Ochaligne/2-DOF-helicopter-control/README.md

# 2-DOF-helicopter-control
Two degree of freedom helicopter Arduino based control prototype.

This project was interrupted by the Covid crisis. The software development was put on hold. All other activities were completed.
