Ochaligne/2-DOF-helicopter-control/MATLAB Simulation/No decoupler/System no decoupler.png

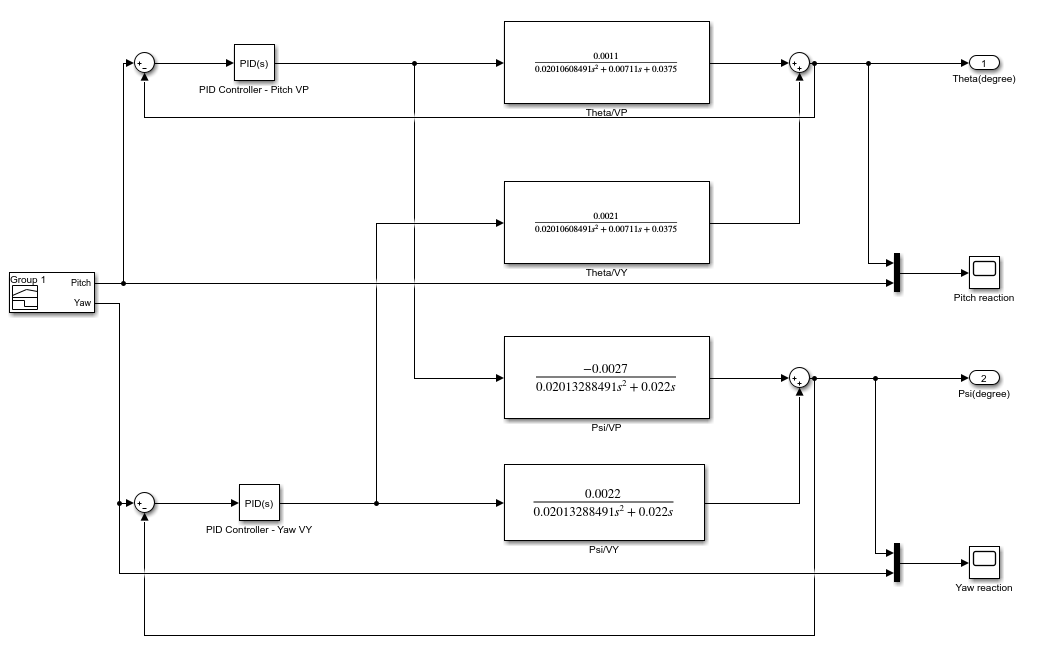
MATLAB Simulation/No decoupler/System no decoupler.png
