Ochaligne/2-DOF-helicopter-control/MATLAB Simulation/No decoupler/Yaw1.PNG

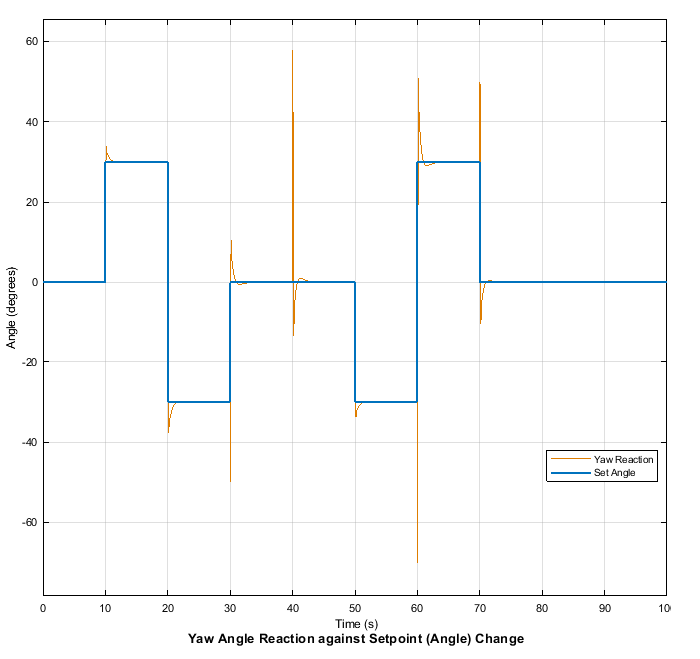
MATLAB Simulation/No decoupler/Yaw1.PNG
