Ochaligne/2-DOF-helicopter-control/MATLAB Simulation/With decoupler/Pitch2.PNG

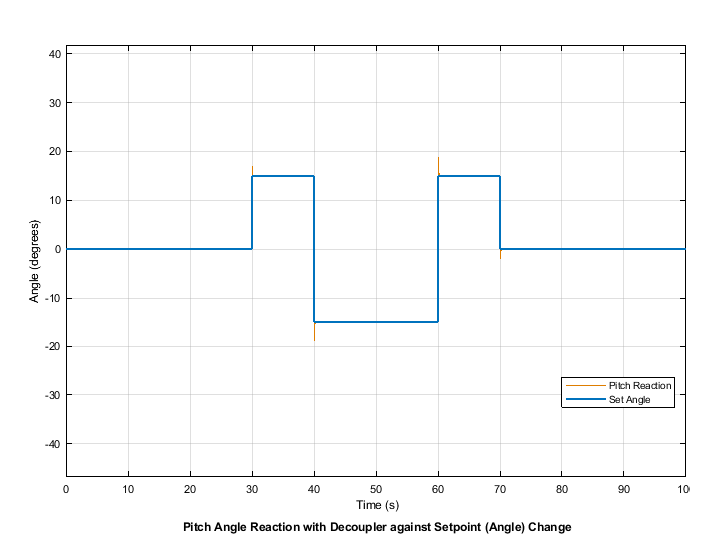
MATLAB Simulation/With decoupler/Pitch2.PNG
