Ochaligne/2-DOF-helicopter-control/MATLAB Simulation/With decoupler/system decoupler.PNG

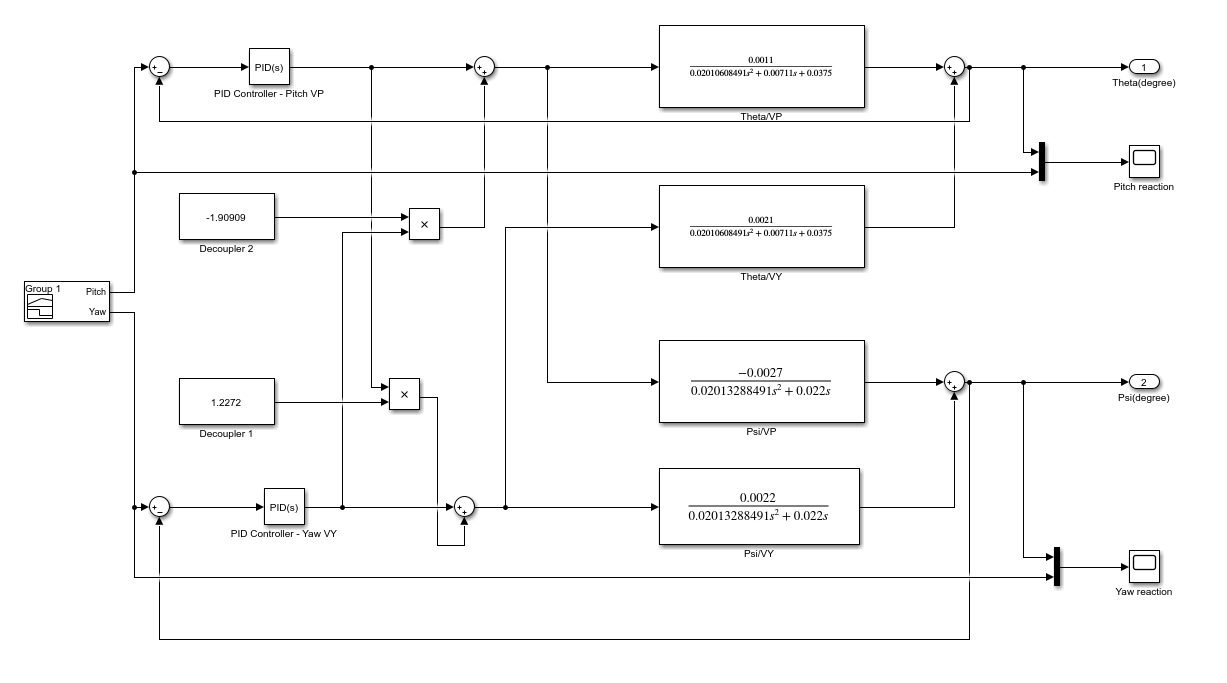
MATLAB Simulation/With decoupler/system decoupler.PNG
