Ochaligne/2-DOF-helicopter-control/MATLAB Simulation/With decoupler/Yaw2.PNG

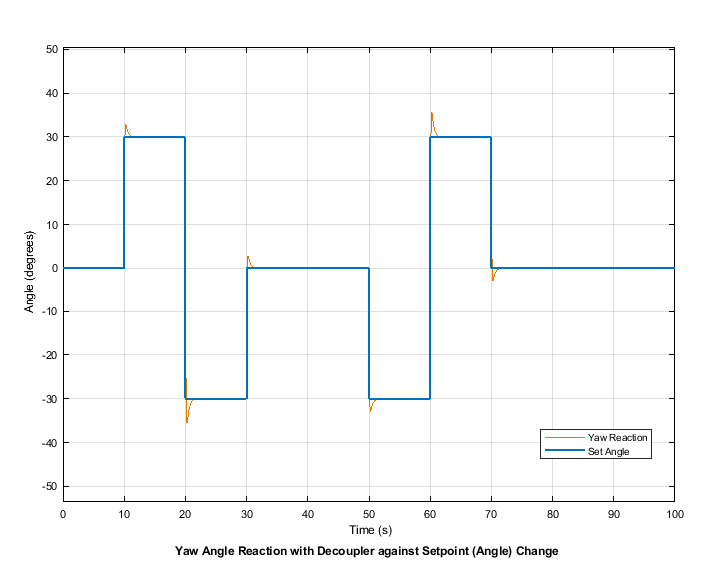
MATLAB Simulation/With decoupler/Yaw2.PNG
