Ochaligne/2-DOF-helicopter-control/CAD - Drawings/2DOF_2_Full_Assembly.pdf

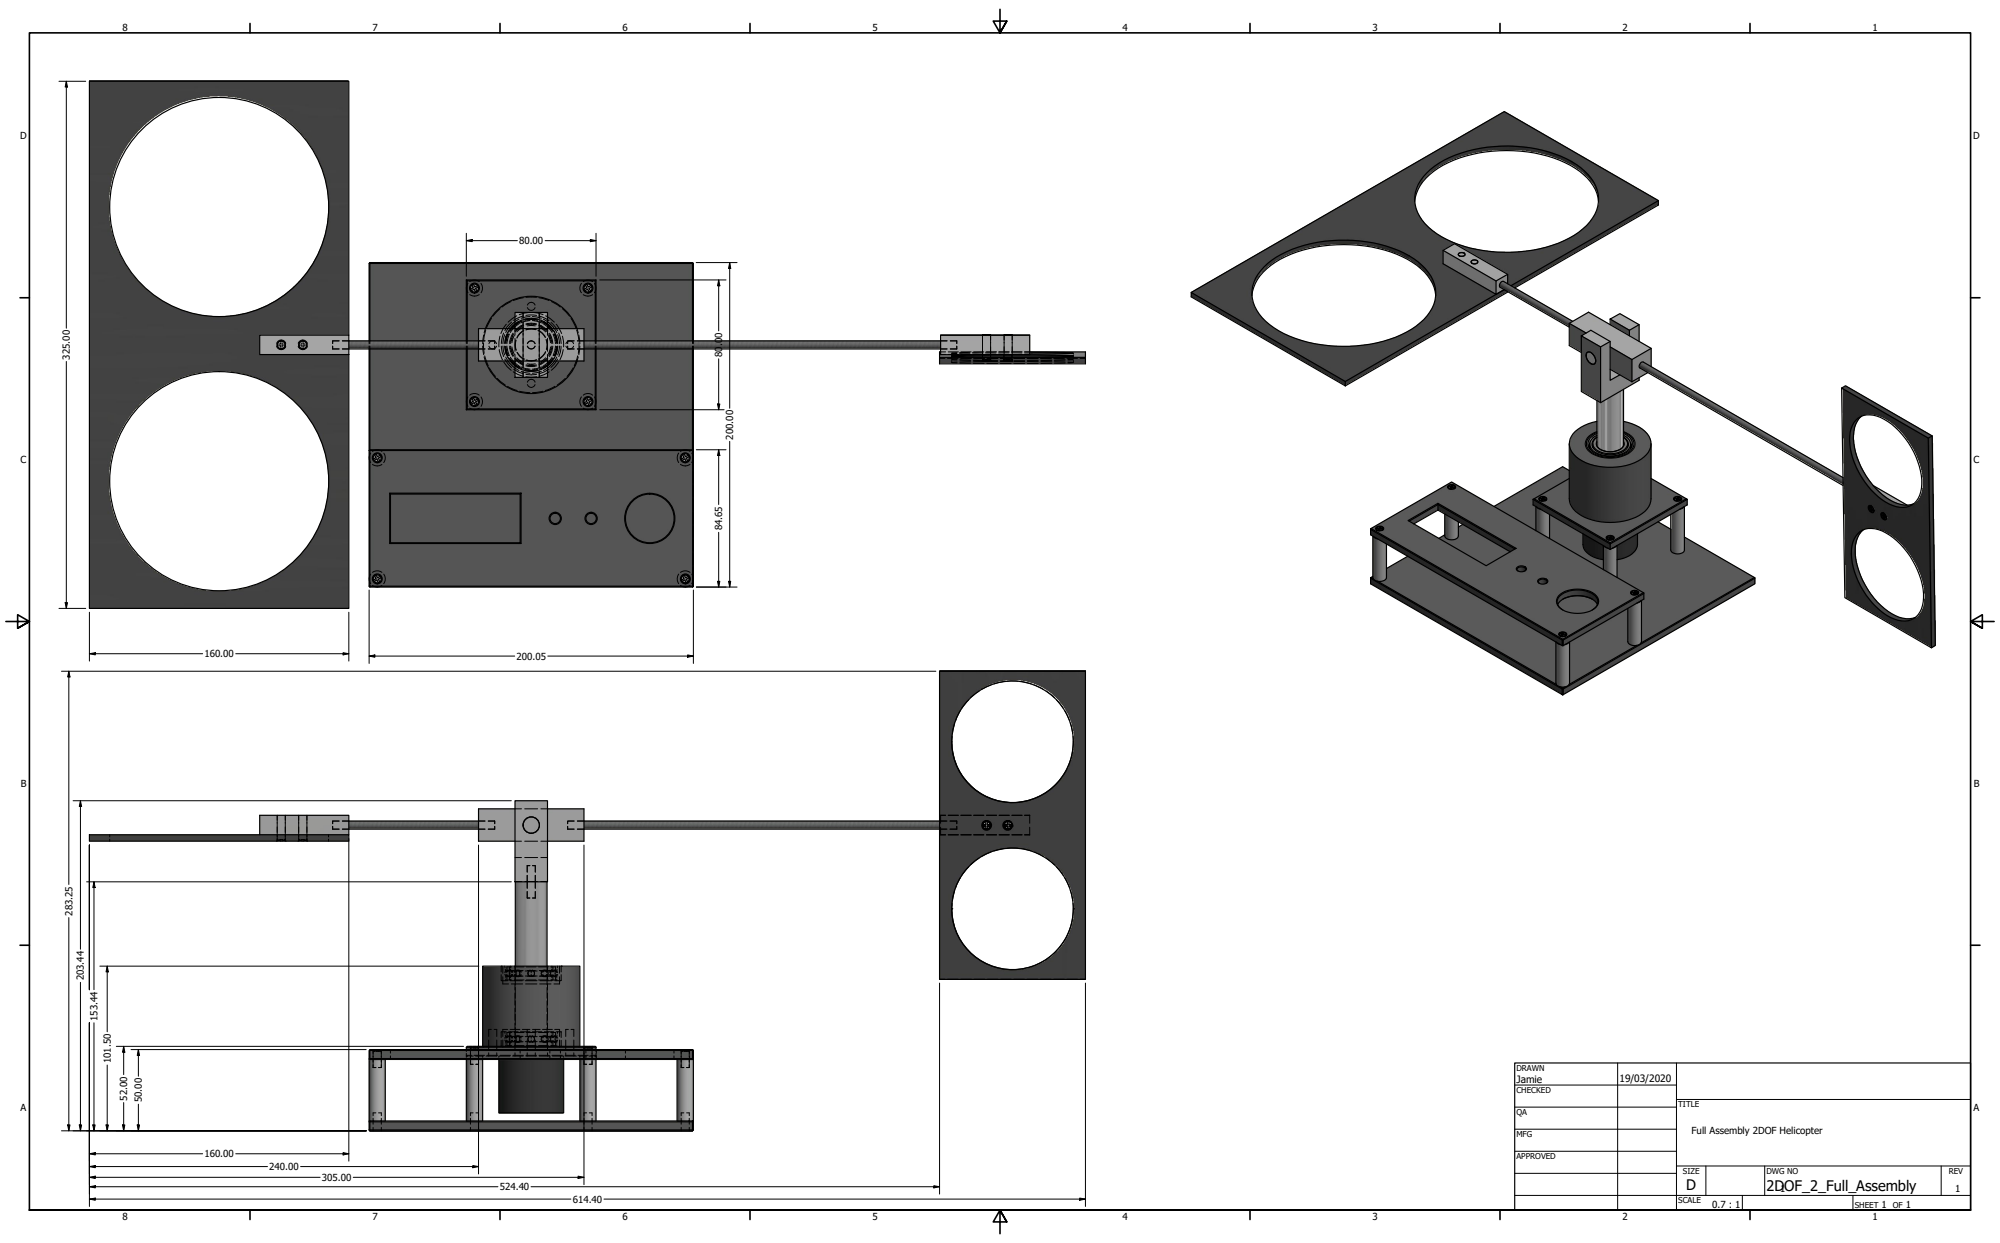
[picture p19: page 1]
SHEET 1 OF 1; DWG NO

DRAWN Jamie | 19/03/2020

CHECKED

Full Assembly 2DOF Helicopter

MFG

APPROVED
