Ochaligne/2-DOF-helicopter-control/CAD - Drawings/Block_Assembly_2DOF.pdf

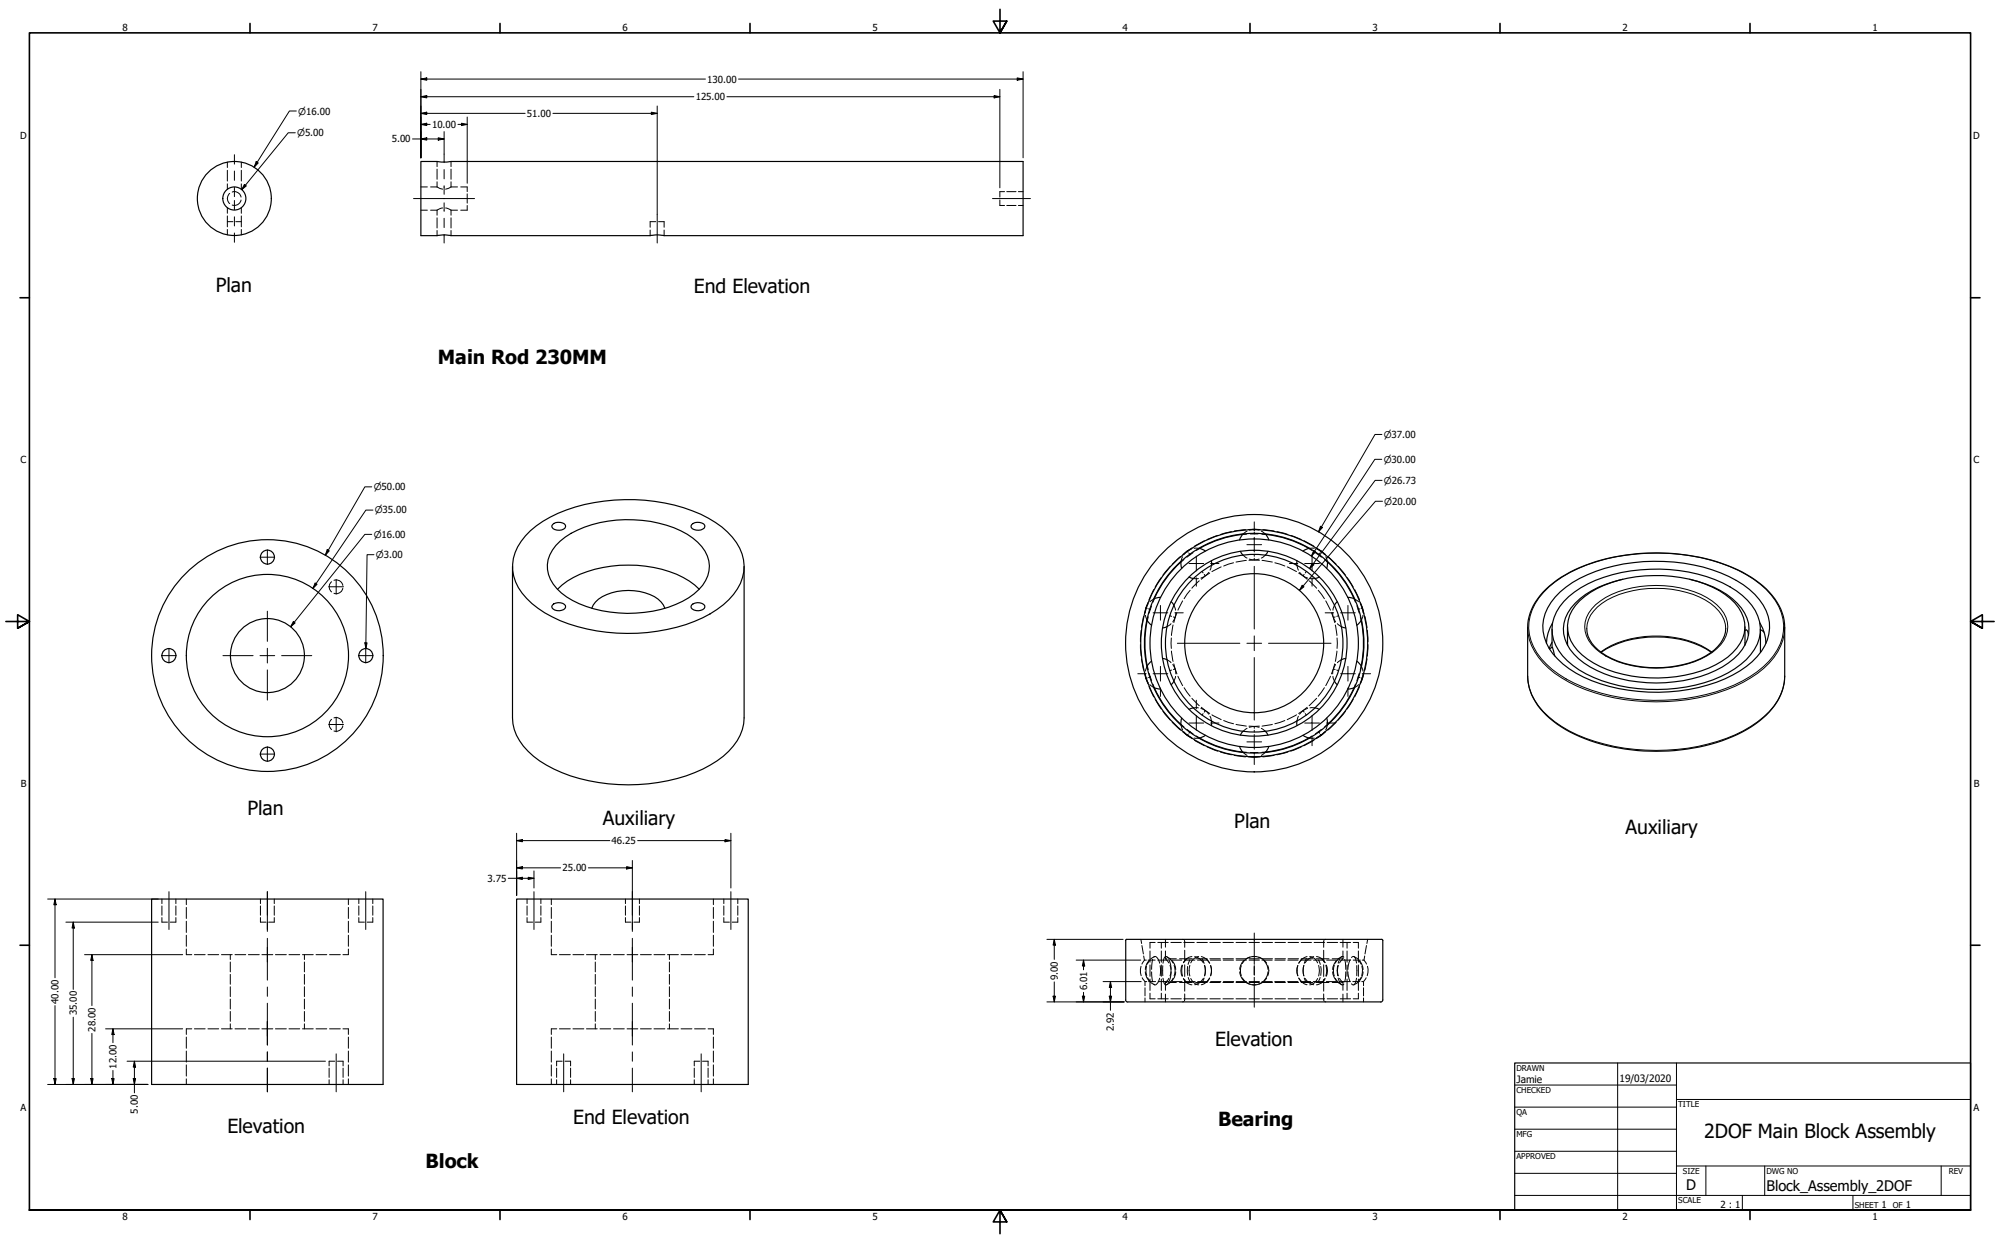
[picture p20: page 1]
2DOF Main Block Assembly; End Elevation; Plan; Main Rod 230MM

MFG

APPROVED

SIZE D | DWG NO Block_Assembly_2DOF | REV

SCALE 2 : 1 | | SHEET 1 OF 1
