Ochaligne/2-DOF-helicopter-control/CAD - Drawings/2DOF RODS.pdf

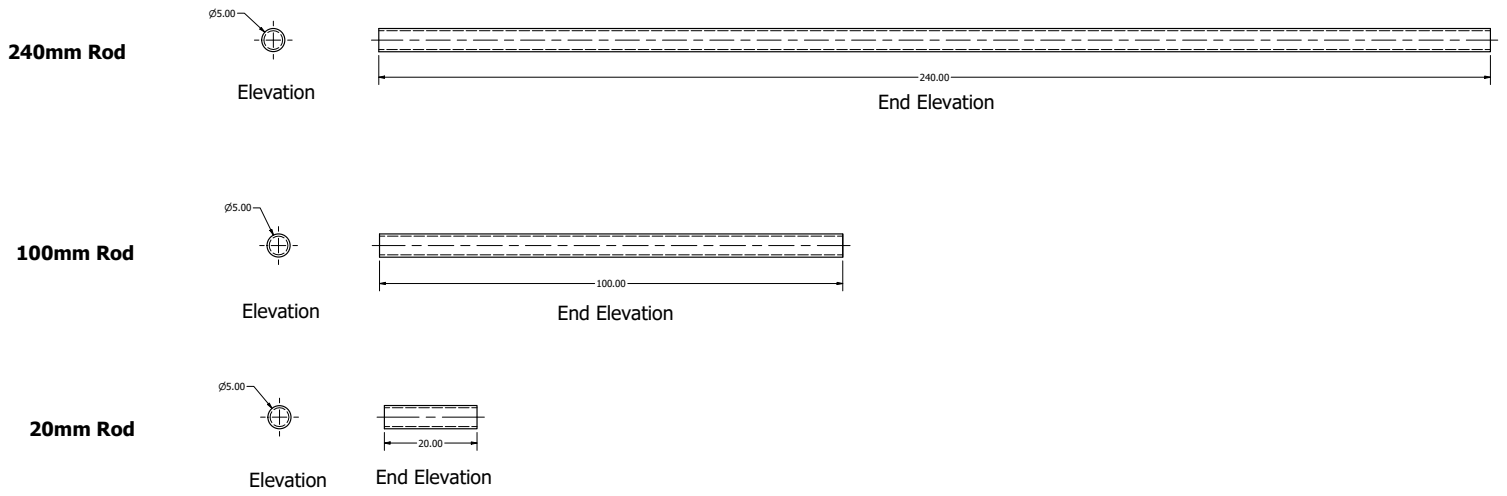
[picture p21: page 1]
End Elevation; Elevation; 240mm Rod; 100mm Rod; 20mm Rod

DRAWN Jamie | 19/03/2020

CHECKED

MFG

APPROVED

SIZE D | DWG NO TR240 | REV

SCALE 2 : 1 | | SHEET 1 OF 1
