Ochaligne/2-DOF-helicopter-control/CAD - Drawings/Fan MOUNT 2DOF.pdf

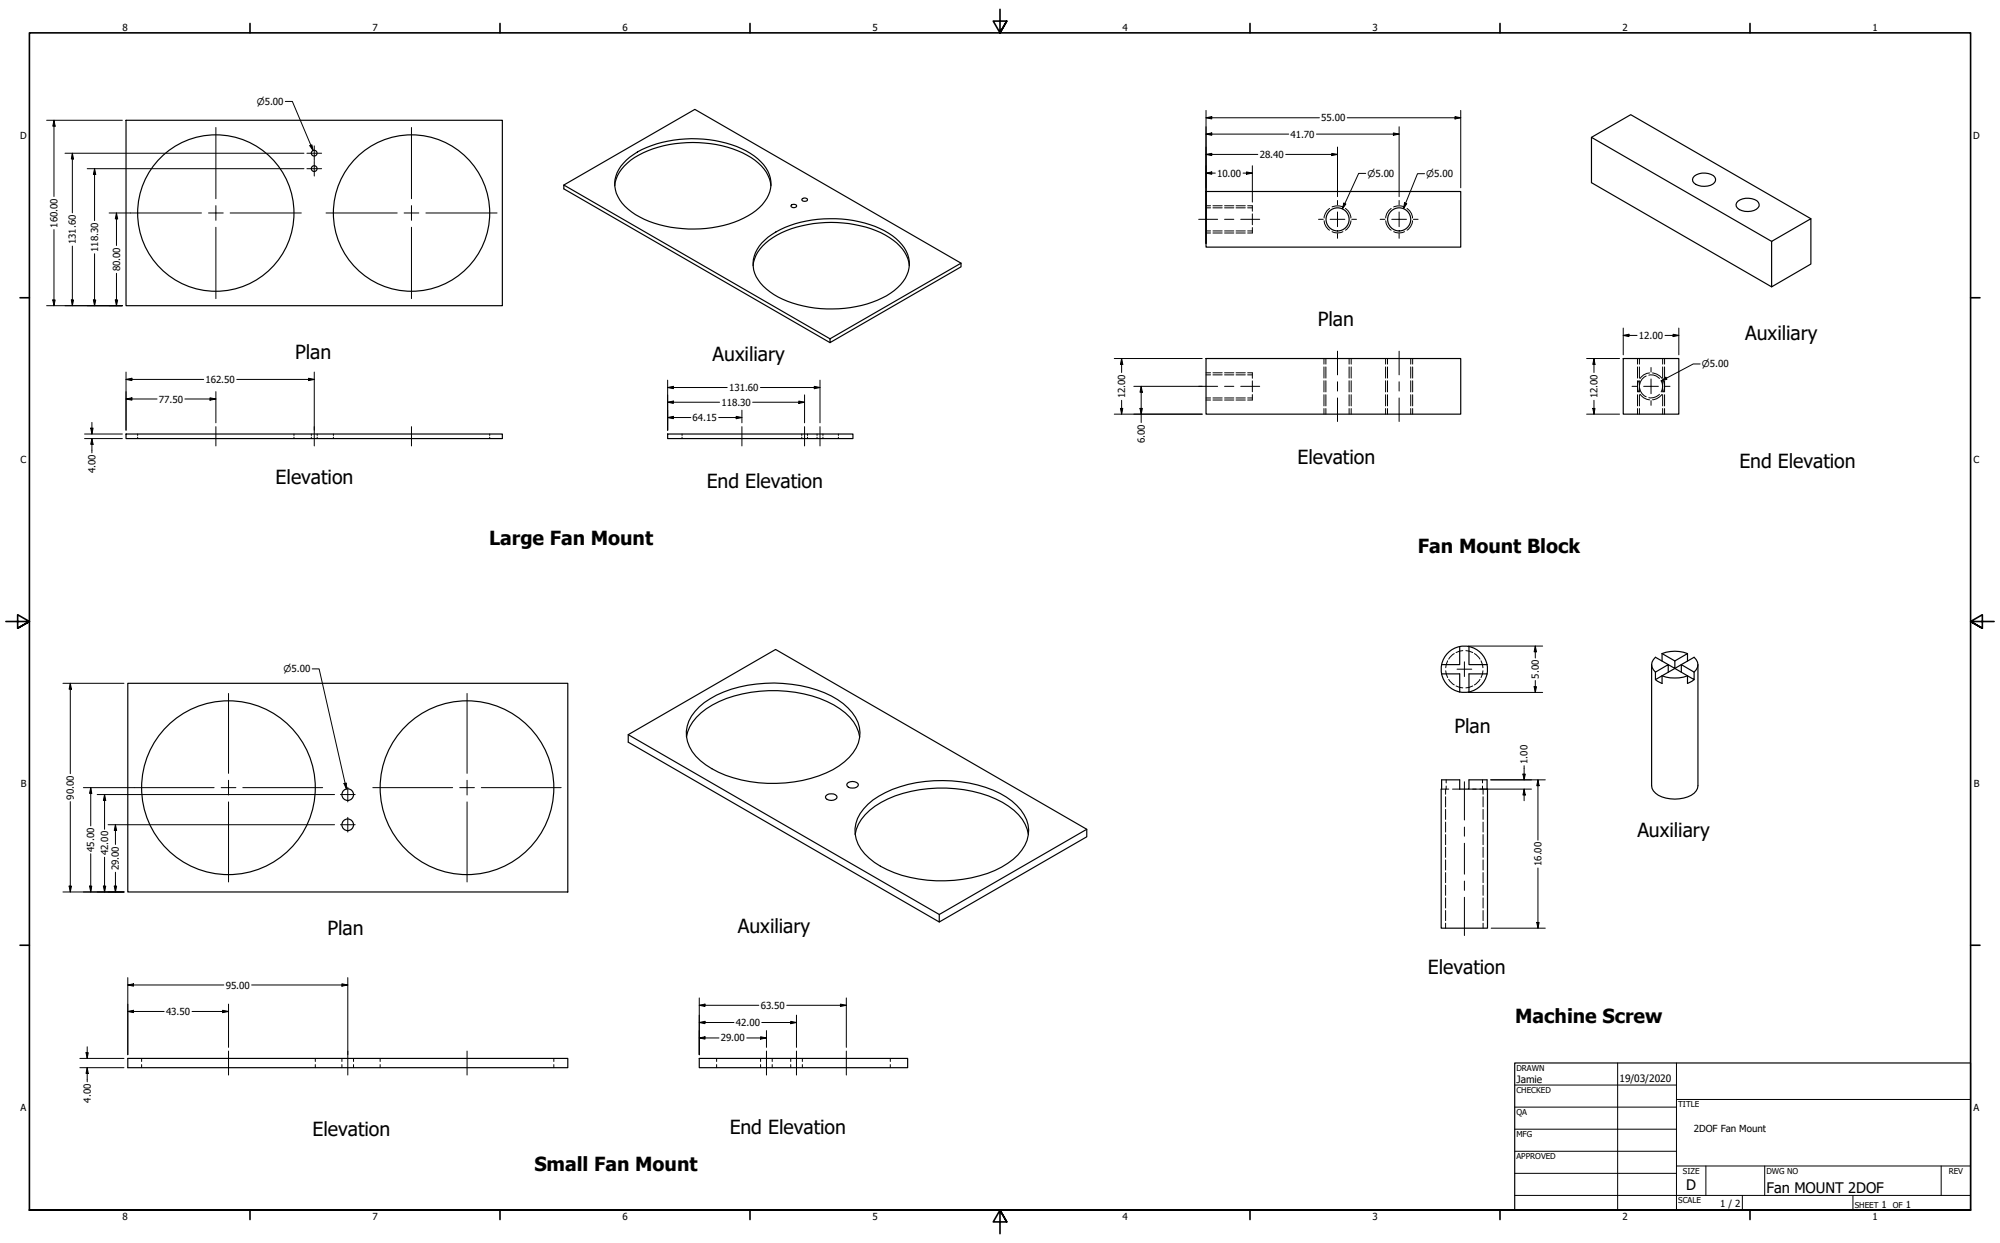
[picture p22: page 1]
Elevation; End Elevation; Machine Screw; 2DOF Fan Mount

Large Fan Mount

Fan Mount Block

DRAWN Jamie | 19/03/2020

CHECKED

MFG

APPROVED

Small Fan Mount

SIZE D | DWG NO Fan MOUNT 2DOF | REV

SCALE 1 / 2 | | SHEET 1 OF 1
