Ochaligne/2-DOF-helicopter-control/CAD - Drawings/TOP_PLATE_2DOF.pdf

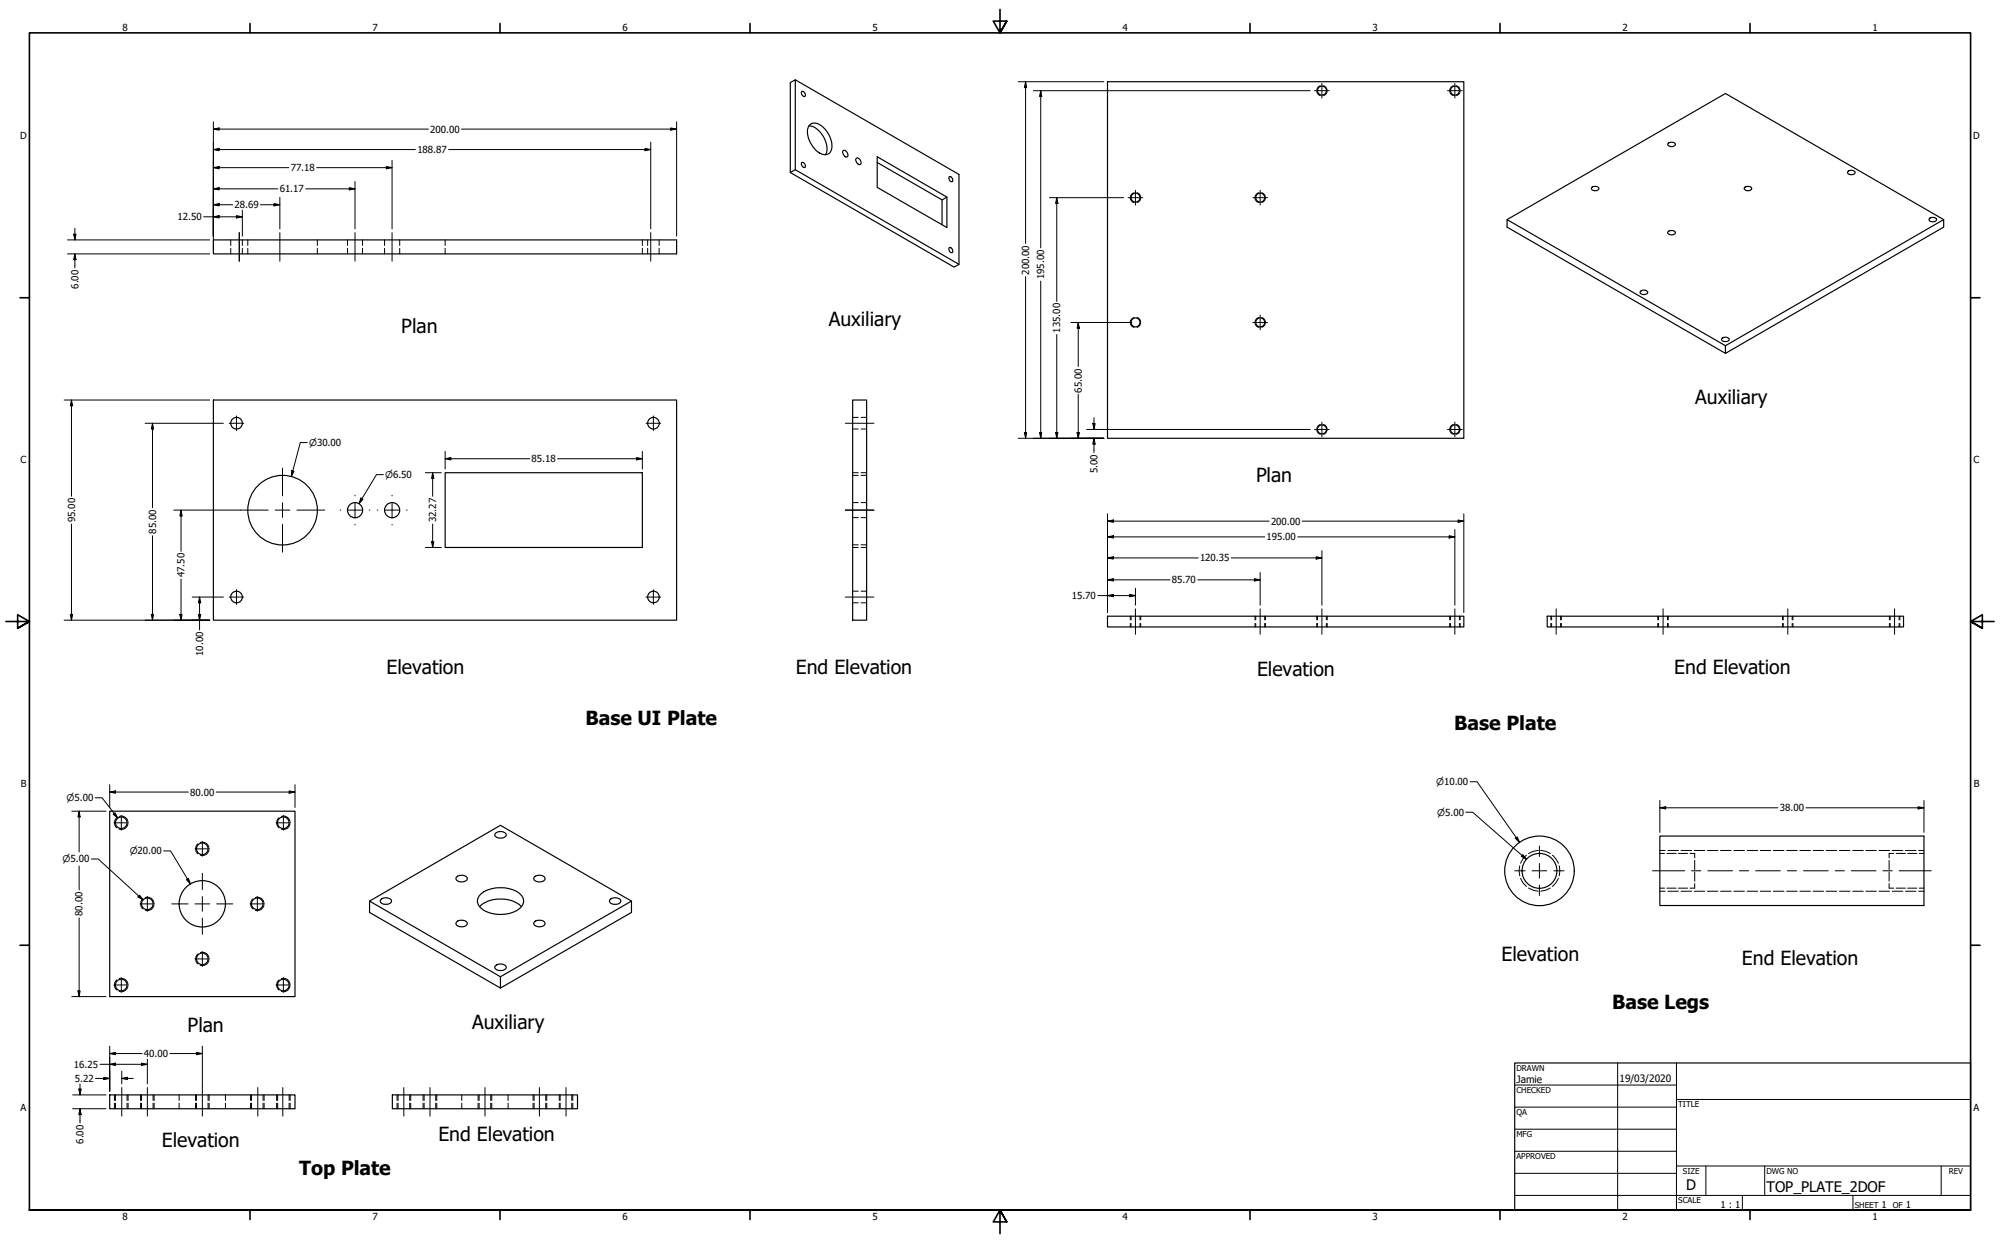
[picture p23: page 1]
End Elevation; Elevation; Base Legs; Base UI Plate; Base Plate; Top Plate

DRAWN Jamie | 19/03/2020

CHECKED

MFG

APPROVED

SIZE D | DWG NO TOP_PLATE_2DOF | REV

SCALE 1 : 1 | | SHEET 1 OF 1
