Ochaligne/2-DOF-helicopter-control/CAD - Drawings/YOKE_DRAWINGS.pdf

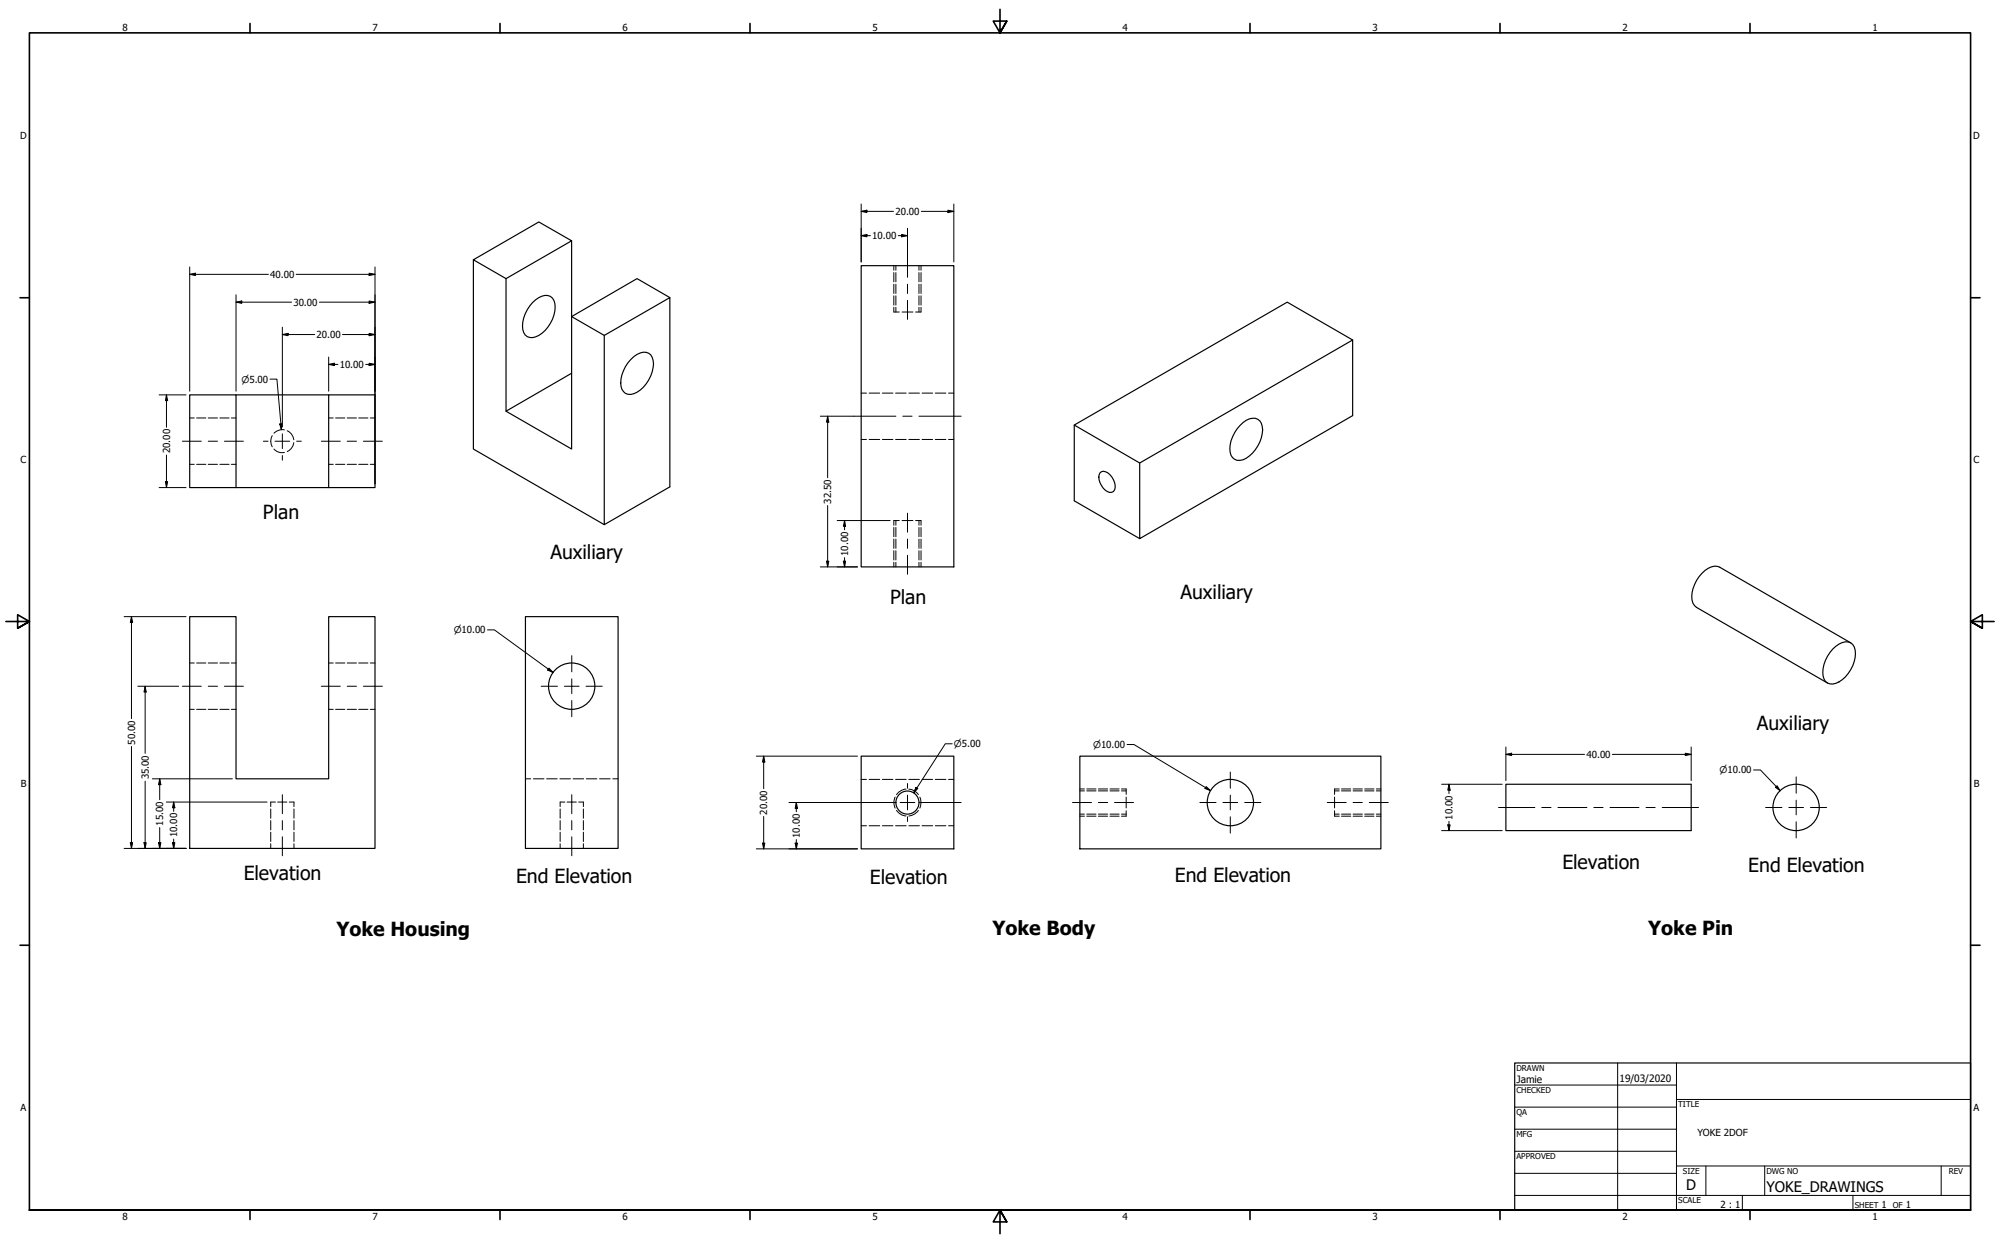
[picture p24: page 1]
End Elevation; Yoke Housing; Elevation; Yoke Body; YOKE 2DOF; Yoke Pin

DRAWN Jamie | 19/03/2020

CHECKED

MFG

APPROVED

SIZE D | DWG NO YOKE_DRAWINGS | REV

SCALE 2 : 1 | | SHEET 1 OF 1
